sagarreddypatil/keyboard/pcb/pcb.kicad_pcb

## KiCad design pcb/pcb.kicad_pcb (2025-10-16)

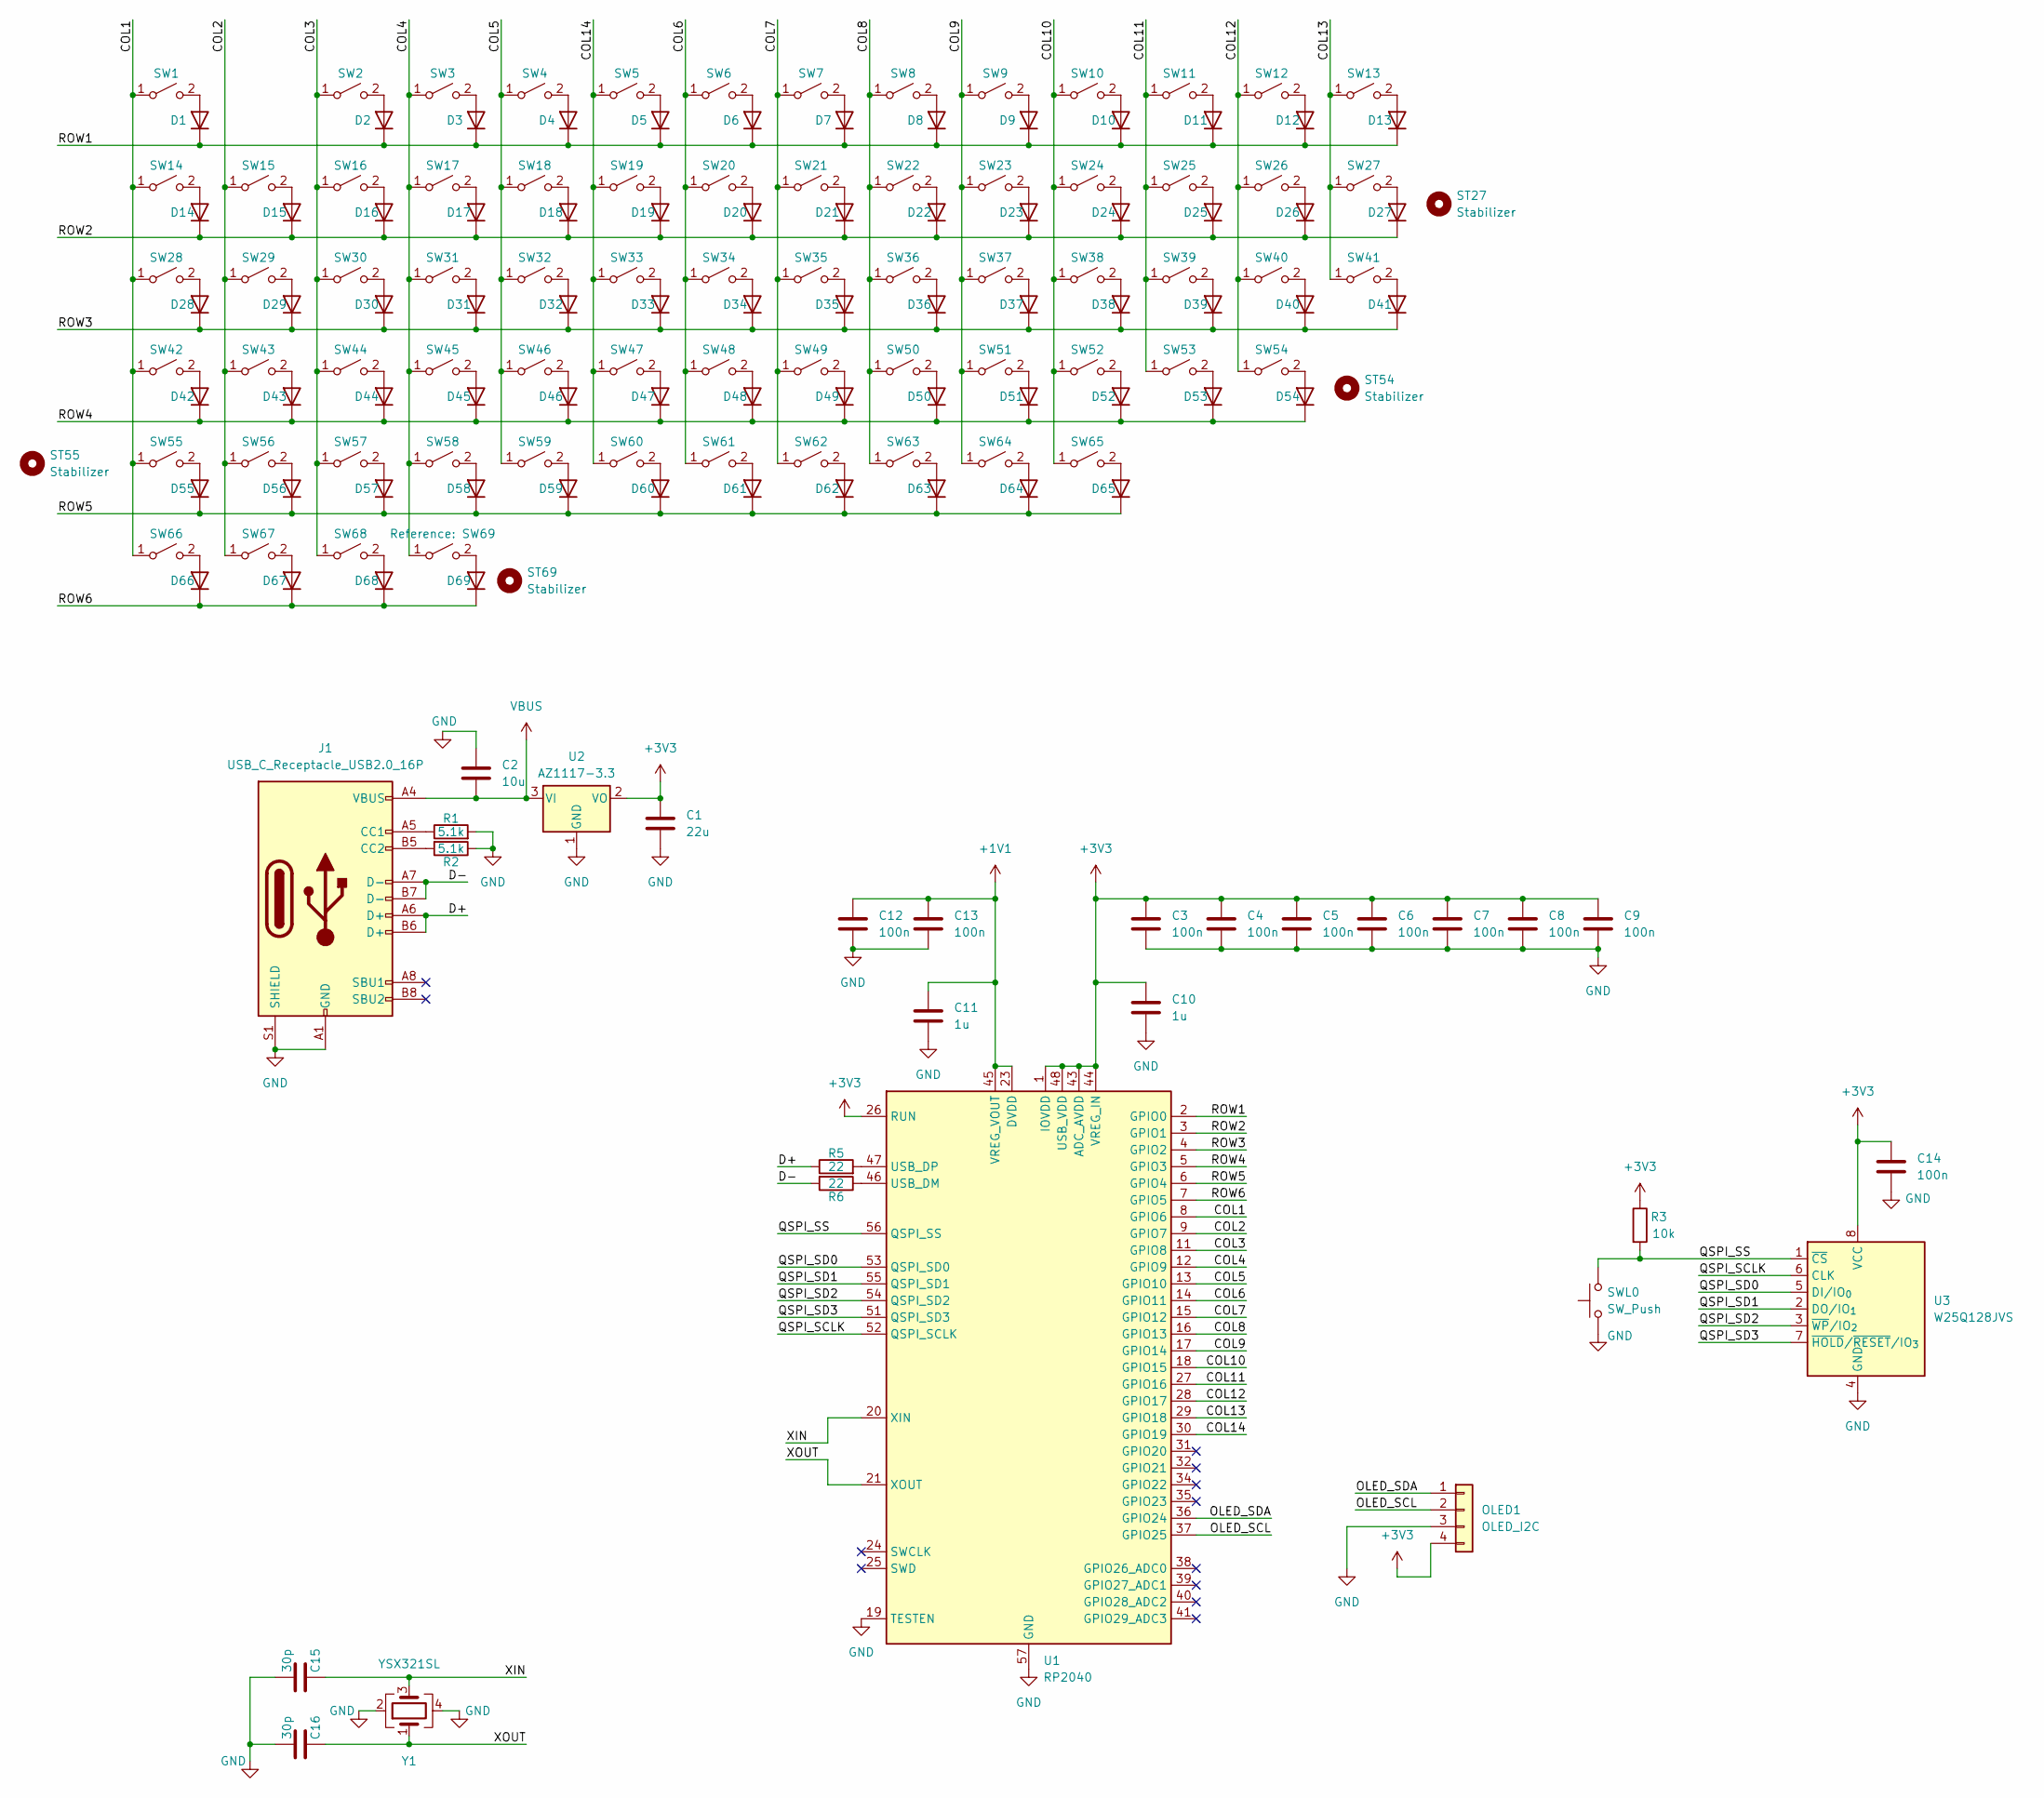
[picture p1: schematic pcb.kicad_sch]

Parts:
C1: 22u; C_0603_1608Metric; LCSC C59461
C2: 10u; C_0603_1608Metric; LCSC C19702
C3, C4, C5, C6, C7, C8, C9, C12, C13, C14: 100n; C_0402_1005Metric; LCSC C1525
C10, C11: 1u; C_0402_1005Metric; LCSC C52923
C15, C16: 30p; C_0603_1608Metric; LCSC C1658
D1, D2, D3, D4, D5, D6, D7, D8, D9, D10, D11, D12, D13, D14, D15, D16, D17, D18, D19, D20, D21, D22, D23, D24, D25, D26, D27, D28, D29, D30, D31, D32, D33, D34, D35, D36, D37, D38, D39, D40, D41, D42, D43, D44, D45, D46, D47, D48, D49, D50, D51, D52, D53, D54, D55, D56, D57, D58, D59, D60, D61, D62, D63, D64, D65, D66, D67, D68, D69: 1N4148WS; D_SOD-323; LCSC C2128
J1: USB_C_Receptacle_USB2.0_16P; USB_C_Receptacle_G-Switch_GT-USB-7010ASV; LCSC C2927037
OLED1: OLED_I2C; PinHeader_1x04_P2.54mm_Vertical
R1, R2: 5.1k; R_0402_1005Metric; LCSC C25905
R3: 10k; R_0402_1005Metric; LCSC C25744
R5, R6: 22; R_0402_1005Metric; LCSC C25092
ST27, ST54, ST55: Stabilizer; Stabilizer_Cherry_MX_2.00u
ST69: Stabilizer; Stabilizer_Cherry_MX_6.25u
SW1, SW13: SW_SPST; SW_Cherry_MX_PCB_1.00u
SW2, SW3, SW4, SW5, SW6, SW7, SW8, SW9, SW10, SW11, SW12, SW14, SW15, SW16, SW17, SW18, SW19, SW20, SW21, SW22, SW23, SW24, SW25, SW26, SW28, SW29, SW30, SW31, SW32, SW33, SW34, SW35, SW36, SW37, SW38, SW39, SW40, SW42, SW43, SW44, SW45, SW46, SW47, SW48, SW49, SW50, SW51, SW52, SW53, SW56, SW57, SW58, SW59, SW60, SW61, SW62, SW63, SW64, SW65, SW66, SW67, SW68: SW_SPST; SW_Cherry_MX_PCB
SW27: SW_SPST; SW_Cherry_MX_PCB_2.00u
SW41: SW_SPST; SW_Cherry_MX_PCB_1.50u
SW54, SW55: SW_SPST; SW_Cherry_MX_PCB_2.25u
SW69: SW_SPST; SW_Cherry_MX_PCB_6.25u
SWL0: SW_Push; SW_Push_1P1T_XKB_TS-1187A; LCSC C318884
U1: RP2040; QFN-56-1EP_7x7mm_P0.4mm_EP3.2x3.2mm; LCSC C2040
U2: AZ1117-3.3; SOT-223-3_TabPin2; LCSC C6186
U3: W25Q128JVS; SOIC-8_5.3x5.3mm_P1.27mm; LCSC C97521
Y1: YSX321SL; Crystal_SMD_3225-4Pin_3.2x2.5mm; LCSC C9002

Connections:
+1V1: C11.1, C12.1, C13.1, U1.23 (DVDD), U1.45 (VREG_VOUT), U1.50 (DVDD)
+3V3: C1.1, C3.1, C4.1, C5.1, C6.1, C7.1, C8.1, C9.1, C10.1, C14.1, OLED1.4 (VCC), R3.1, U1.1 (IOVDD), U1.10 (IOVDD), U1.22 (IOVDD), U1.26 (RUN), U1.33 (IOVDD), U1.42 (IOVDD), U1.43 (ADC_AVDD), U1.44 (VREG_IN), U1.48 (USB_VDD), U1.49 (IOVDD), U2.2 (VO), U3.8 (VCC)
/COL1: SW1.1 (A), SW14.1 (A), SW28.1 (A), SW42.1 (A), SW55.1 (A), SW66.1 (A), U1.8 (GPIO6)
/COL2: SW15.1 (A), SW29.1 (A), SW43.1 (A), SW56.1 (A), SW67.1 (A), U1.9 (GPIO7)
/COL3: SW2.1 (A), SW16.1 (A), SW30.1 (A), SW44.1 (A), SW57.1 (A), SW68.1 (A), U1.11 (GPIO8)
/COL4: SW3.1 (A), SW17.1 (A), SW31.1 (A), SW45.1 (A), SW58.1 (A), SW69.1 (A), U1.12 (GPIO9)
/COL5: SW4.1 (A), SW18.1 (A), SW32.1 (A), SW46.1 (A), SW59.1 (A), U1.13 (GPIO10)
/COL6: SW6.1 (A), SW20.1 (A), SW34.1 (A), SW48.1 (A), SW61.1 (A), U1.14 (GPIO11)
/COL7: SW7.1 (A), SW21.1 (A), SW35.1 (A), SW49.1 (A), SW62.1 (A), U1.15 (GPIO12)
/COL8: SW8.1 (A), SW22.1 (A), SW36.1 (A), SW50.1 (A), SW63.1 (A), U1.16 (GPIO13)
/COL9: SW9.1 (A), SW23.1 (A), SW37.1 (A), SW51.1 (A), SW64.1 (A), U1.17 (GPIO14)
/COL10: SW10.1 (A), SW24.1 (A), SW38.1 (A), SW52.1 (A), SW65.1 (A), U1.18 (GPIO15)
/COL11: SW11.1 (A), SW25.1 (A), SW39.1 (A), SW53.1 (A), U1.27 (GPIO16)
/COL12: SW12.1 (A), SW26.1 (A), SW40.1 (A), SW54.1 (A), U1.28 (GPIO17)
/COL13: SW13.1 (A), SW27.1 (A), SW41.1 (A), U1.29 (GPIO18)
/COL14: SW5.1 (A), SW19.1 (A), SW33.1 (A), SW47.1 (A), SW60.1 (A), U1.30 (GPIO19)
/D+: J1.A6 (D+), J1.B6 (D+), R5.1
/D-: J1.A7 (D-), J1.B7 (D-), R6.2
/OLED_SCL: OLED1.2 (SCL), U1.37 (GPIO25)
/OLED_SDA: OLED1.1 (SDA), U1.36 (GPIO24)
/QSPI_SCLK: U1.52 (QSPI_SCLK), U3.6 (CLK)
/QSPI_SD0: U1.53 (QSPI_SD0), U3.5 (DI/IO_{0})
/QSPI_SD1: U1.55 (QSPI_SD1), U3.2 (DO/IO_{1})
/QSPI_SD2: U1.54 (QSPI_SD2), U3.3 (~WP/IO_{2})
/QSPI_SD3: U1.51 (QSPI_SD3), U3.7 (~HOLD/~RESET/IO_{3})
/QSPI_SS: R3.2, SWL0.2, U1.56 (QSPI_SS), U3.1 (~CS)
/ROW1: D1.1 (K), D2.1 (K), D3.1 (K), D4.1 (K), D5.1 (K), D6.1 (K), D7.1 (K), D8.1 (K), D9.1 (K), D10.1 (K), D11.1 (K), D12.1 (K), D13.1 (K), U1.2 (GPIO0)
/ROW2: D14.1 (K), D15.1 (K), D16.1 (K), D17.1 (K), D18.1 (K), D19.1 (K), D20.1 (K), D21.1 (K), D22.1 (K), D23.1 (K), D24.1 (K), D25.1 (K), D26.1 (K), D27.1 (K), U1.3 (GPIO1)
/ROW3: D28.1 (K), D29.1 (K), D30.1 (K), D31.1 (K), D32.1 (K), D33.1 (K), D34.1 (K), D35.1 (K), D36.1 (K), D37.1 (K), D38.1 (K), D39.1 (K), D40.1 (K), D41.1 (K), U1.4 (GPIO2)
/ROW4: D42.1 (K), D43.1 (K), D44.1 (K), D45.1 (K), D46.1 (K), D47.1 (K), D48.1 (K), D49.1 (K), D50.1 (K), D51.1 (K), D52.1 (K), D53.1 (K), D54.1 (K), U1.5 (GPIO3)
/ROW5: D55.1 (K), D56.1 (K), D57.1 (K), D58.1 (K), D59.1 (K), D60.1 (K), D61.1 (K), D62.1 (K), D63.1 (K), D64.1 (K), D65.1 (K), U1.6 (GPIO4)
/ROW6: D66.1 (K), D67.1 (K), D68.1 (K), D69.1 (K), U1.7 (GPIO5)
/XIN: C15.2, U1.20 (XIN), Y1.3
/XOUT: C16.2, U1.21 (XOUT), Y1.1
GND: C1.2, C2.1, C3.2, C4.2, C5.2, C6.2, C7.2, C8.2, C9.2, C10.2, C11.2, C12.2, C13.2, C14.2, C15.1, C16.1, J1.A1 (GND), J1.A12 (GND), J1.B1 (GND), J1.B12 (GND), J1.S1 (SHIELD), OLED1.3 (GND), R1.2, R2.1, SWL0.1, U1.19 (TESTEN), U1.57 (GND), U2.1 (GND), U3.4 (GND), Y1.2, Y1.4
unnamed: D1.2 (A), SW1.2 (B)
unnamed: D2.2 (A), SW2.2 (B)
unnamed: D3.2 (A), SW3.2 (B)
unnamed: D4.2 (A), SW4.2 (B)
unnamed: D5.2 (A), SW5.2 (B)
unnamed: D6.2 (A), SW6.2 (B)
unnamed: D7.2 (A), SW7.2 (B)
unnamed: D8.2 (A), SW8.2 (B)
unnamed: D9.2 (A), SW9.2 (B)
unnamed: D10.2 (A), SW10.2 (B)
unnamed: D11.2 (A), SW11.2 (B)
unnamed: D12.2 (A), SW12.2 (B)
unnamed: D13.2 (A), SW13.2 (B)
unnamed: D14.2 (A), SW14.2 (B)
unnamed: D15.2 (A), SW15.2 (B)
unnamed: D16.2 (A), SW16.2 (B)
unnamed: D17.2 (A), SW17.2 (B)
unnamed: D18.2 (A), SW18.2 (B)
unnamed: D19.2 (A), SW19.2 (B)
unnamed: D20.2 (A), SW20.2 (B)
unnamed: D21.2 (A), SW21.2 (B)
unnamed: D22.2 (A), SW22.2 (B)
unnamed: D23.2 (A), SW23.2 (B)
unnamed: D24.2 (A), SW24.2 (B)
unnamed: D25.2 (A), SW25.2 (B)
unnamed: D26.2 (A), SW26.2 (B)
unnamed: D27.2 (A), SW27.2 (B)
unnamed: D28.2 (A), SW28.2 (B)
unnamed: D29.2 (A), SW29.2 (B)
unnamed: D30.2 (A), SW30.2 (B)
unnamed: D31.2 (A), SW31.2 (B)
unnamed: D32.2 (A), SW32.2 (B)
unnamed: D33.2 (A), SW33.2 (B)
unnamed: D34.2 (A), SW34.2 (B)
unnamed: D35.2 (A), SW35.2 (B)
unnamed: D36.2 (A), SW36.2 (B)
unnamed: D37.2 (A), SW37.2 (B)
unnamed: D38.2 (A), SW38.2 (B)
unnamed: D39.2 (A), SW39.2 (B)
unnamed: D40.2 (A), SW40.2 (B)
unnamed: D41.2 (A), SW41.2 (B)
unnamed: D42.2 (A), SW42.2 (B)
unnamed: D43.2 (A), SW43.2 (B)
unnamed: D44.2 (A), SW44.2 (B)
unnamed: D45.2 (A), SW45.2 (B)
unnamed: D46.2 (A), SW46.2 (B)
unnamed: D47.2 (A), SW47.2 (B)
unnamed: D48.2 (A), SW48.2 (B)
unnamed: D49.2 (A), SW49.2 (B)
unnamed: D50.2 (A), SW50.2 (B)
unnamed: D51.2 (A), SW51.2 (B)
unnamed: D52.2 (A), SW52.2 (B)
unnamed: D53.2 (A), SW53.2 (B)
unnamed: D54.2 (A), SW54.2 (B)
unnamed: D55.2 (A), SW55.2 (B)
unnamed: D56.2 (A), SW56.2 (B)
unnamed: D57.2 (A), SW57.2 (B)
unnamed: D58.2 (A), SW58.2 (B)
unnamed: D59.2 (A), SW59.2 (B)
unnamed: D60.2 (A), SW60.2 (B)
unnamed: D61.2 (A), SW61.2 (B)
unnamed: D62.2 (A), SW62.2 (B)
unnamed: D63.2 (A), SW63.2 (B)
unnamed: D64.2 (A), SW64.2 (B)
unnamed: D65.2 (A), SW65.2 (B)
unnamed: D66.2 (A), SW66.2 (B)
unnamed: D67.2 (A), SW67.2 (B)
unnamed: D68.2 (A), SW68.2 (B)
unnamed: D69.2 (A), SW69.2 (B)
unnamed: J1.A5 (CC1), R1.1
unnamed: J1.B5 (CC2), R2.2
unnamed: R6.1, U1.46 (USB_DM)
unnamed: R5.2, U1.47 (USB_DP)
VBUS: C2.2, J1.A4 (VBUS), J1.A9 (VBUS), J1.B4 (VBUS), J1.B9 (VBUS), U2.3 (VI)

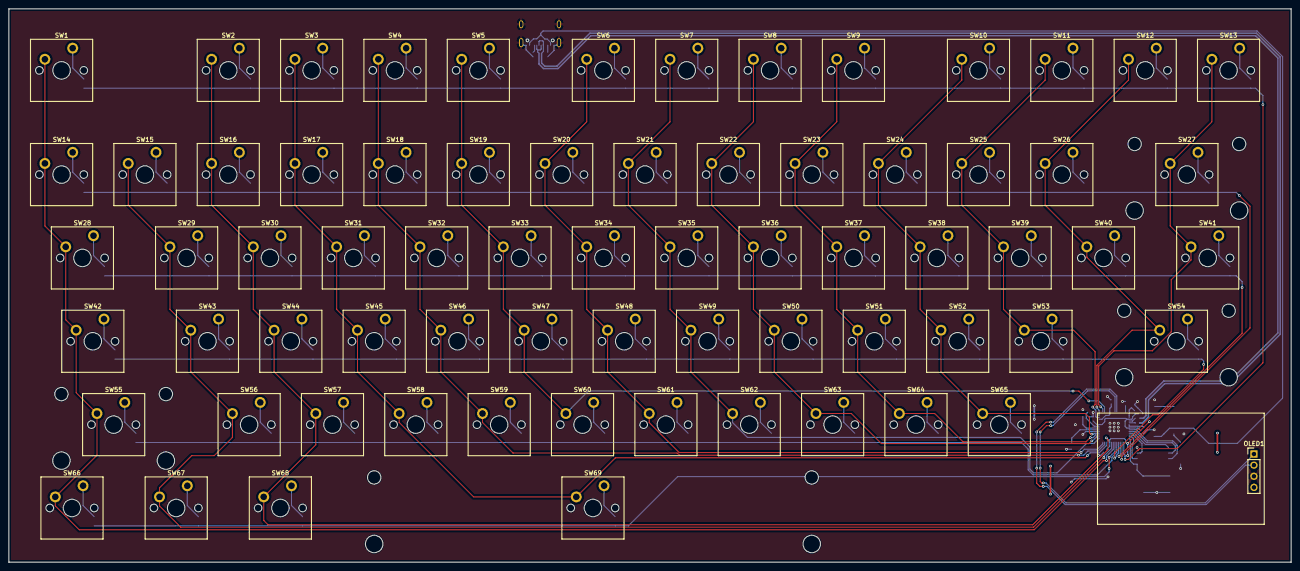
[picture p2: board pcb.kicad_pcb from above]

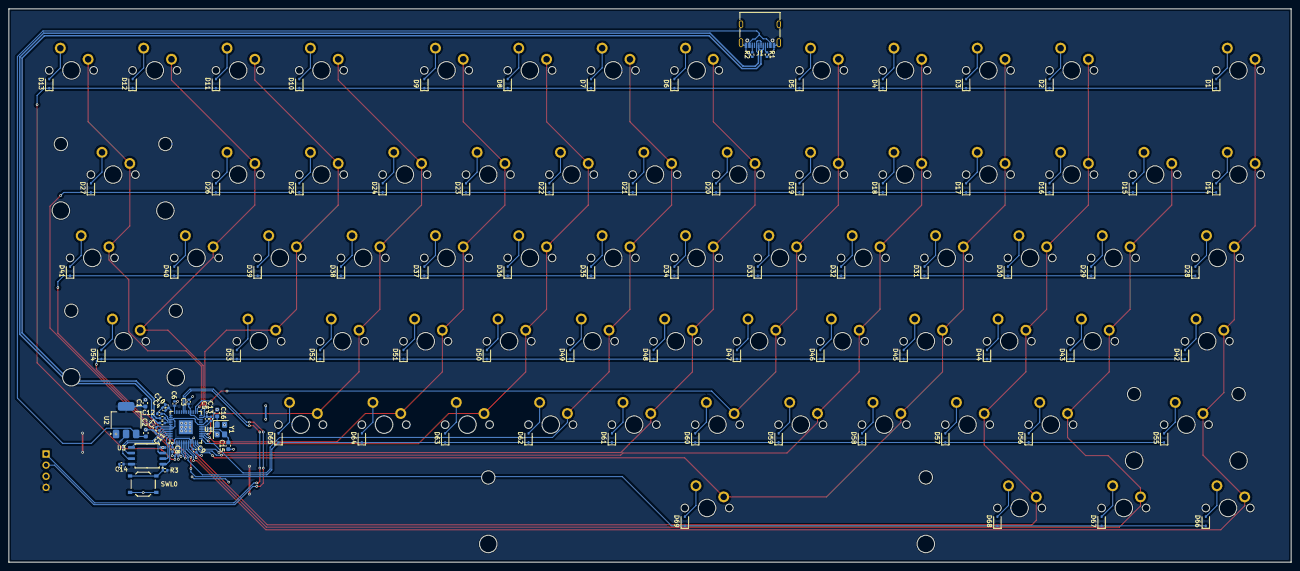
[picture p3: board pcb.kicad_pcb from below]

Board: 2 copper layers, 293.1 x 126.5 mm, 170 parts (96 on the bottom side), 109 nets.
