sagarreddypatil/keyboard/fw/src/config.h

#pragma once

#include "class/hid/hid.h"
#include "util.h"

static constexpr u64 kDebounceIntervalUs = 5000;

static constexpr u32 kRowPins[] = {0, 1, 2, 3, 4, 5};
static constexpr u32 kRows = ARRAY_SIZE(kRowPins);

static constexpr u32 kColPins[] = {6, 7, 8, 9, 10, 19, 11, 12, 13, 14, 15, 16, 17, 18};
static constexpr u32 kCols = ARRAY_SIZE(kColPins);

// clang-format off
static constexpr u8 kKeymap[kRows][kCols] = {
    {HID_KEY_ESCAPE, 0, HID_KEY_F1, HID_KEY_F2, HID_KEY_F3, HID_KEY_F4, HID_KEY_F5, HID_KEY_F6, HID_KEY_F7, HID_KEY_F8, HID_KEY_F9, HID_KEY_F10, HID_KEY_F11, HID_KEY_F12},
    {HID_KEY_GRAVE, HID_KEY_1, HID_KEY_2, HID_KEY_3, HID_KEY_4, HID_KEY_5, HID_KEY_6, HID_KEY_7, HID_KEY_8, HID_KEY_9, HID_KEY_0, HID_KEY_MINUS, HID_KEY_EQUAL, HID_KEY_BACKSPACE},
    {HID_KEY_TAB, HID_KEY_Q, HID_KEY_W, HID_KEY_E, HID_KEY_R, HID_KEY_T, HID_KEY_Y, HID_KEY_U, HID_KEY_I, HID_KEY_O, HID_KEY_P, HID_KEY_BRACKET_LEFT, HID_KEY_BRACKET_RIGHT, HID_KEY_BACKSLASH},
    {0, HID_KEY_A, HID_KEY_S, HID_KEY_D, HID_KEY_F, HID_KEY_G, HID_KEY_H, HID_KEY_J, HID_KEY_K, HID_KEY_L, HID_KEY_SEMICOLON, HID_KEY_APOSTROPHE, HID_KEY_ENTER},
    {HID_KEY_SHIFT_LEFT, HID_KEY_Z, HID_KEY_X, HID_KEY_C, HID_KEY_V, HID_KEY_B, HID_KEY_N, HID_KEY_M, HID_KEY_COMMA, HID_KEY_PERIOD, HID_KEY_SLASH},
    {HID_KEY_CONTROL_LEFT, HID_KEY_GUI_LEFT, HID_KEY_ALT_LEFT, HID_KEY_SPACE},
};

static constexpr u8 kFnKeymap[kRows][kCols] = {
    {HID_KEY_ESCAPE, 0, HID_KEY_F1, HID_KEY_F2, HID_KEY_F3, HID_KEY_F4, HID_KEY_F5, HID_KEY_F6, HID_KEY_F7, HID_KEY_F8, HID_KEY_F9, HID_KEY_F10, HID_KEY_F11, HID_KEY_F12},
    {HID_KEY_GRAVE, HID_KEY_1, HID_KEY_2, HID_KEY_3, HID_KEY_4, HID_KEY_5, HID_KEY_6, HID_KEY_7, HID_KEY_8, HID_KEY_9, HID_KEY_0, HID_KEY_MINUS, HID_KEY_EQUAL, HID_KEY_BACKSPACE},
    {HID_KEY_TAB, HID_KEY_Q, HID_KEY_W, HID_KEY_E, HID_KEY_R, HID_KEY_T, HID_KEY_Y, HID_KEY_U, HID_KEY_I, HID_KEY_O, HID_KEY_P, HID_KEY_BRACKET_LEFT, HID_KEY_BRACKET_RIGHT, HID_KEY_BACKSLASH},
    {0, HID_KEY_A, HID_KEY_S, HID_KEY_D, HID_KEY_F, HID_KEY_G, HID_KEY_ARROW_LEFT, HID_KEY_ARROW_DOWN, HID_KEY_ARROW_UP, HID_KEY_ARROW_RIGHT, HID_KEY_SEMICOLON, HID_KEY_APOSTROPHE, HID_KEY_ENTER},
    {HID_KEY_SHIFT_LEFT, HID_KEY_Z, HID_KEY_X, HID_KEY_C, HID_KEY_V, HID_KEY_B, HID_KEY_N, HID_KEY_M, HID_KEY_COMMA, HID_KEY_PERIOD, HID_KEY_SLASH},
    {HID_KEY_CONTROL_LEFT, HID_KEY_GUI_LEFT, HID_KEY_ALT_LEFT, HID_KEY_SPACE},
};
// clang-format on

// Who needs caps lock anyway...
static constexpr u32 kFnRow = 3;
static constexpr u32 kFnCol = 0;

static constexpr u32 kOledSda = 24;
static constexpr u32 kOledScl = 25;
