sagarreddypatil/keyboard/(commit log)

2025-10-14 production version
    [pcb.kicad_pcb, pcb.kicad_sch]
2025-10-16 add stabilizers
    [pcb.kicad_pcb, pcb.kicad_sch]
2025-10-19 new pcb wip
    [pcb.kicad_pcb, pcb.kicad_sch]
2025-10-19 oled read + cheese prevention
    [keyboard.cc, main.cc, util.h]
2025-11-11 remove new design
    [pcb.kicad_pcb, pcb.kicad_sch]
